nygma2004/RFID_Wiegand_MQTT/pcb/kit.jpg

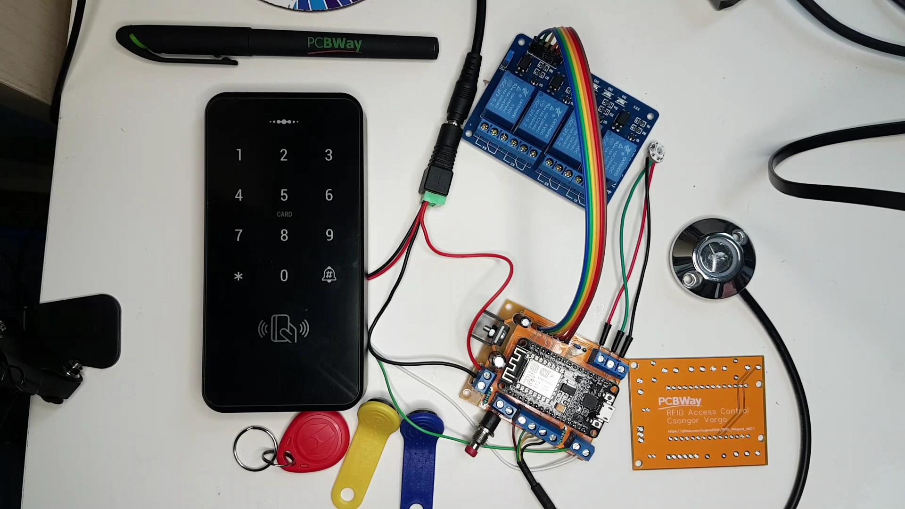
pcb/kit.jpg
