nygma2004/RFID_Wiegand_MQTT/pcb/Schematic_RFID_2021-03-26.pdf

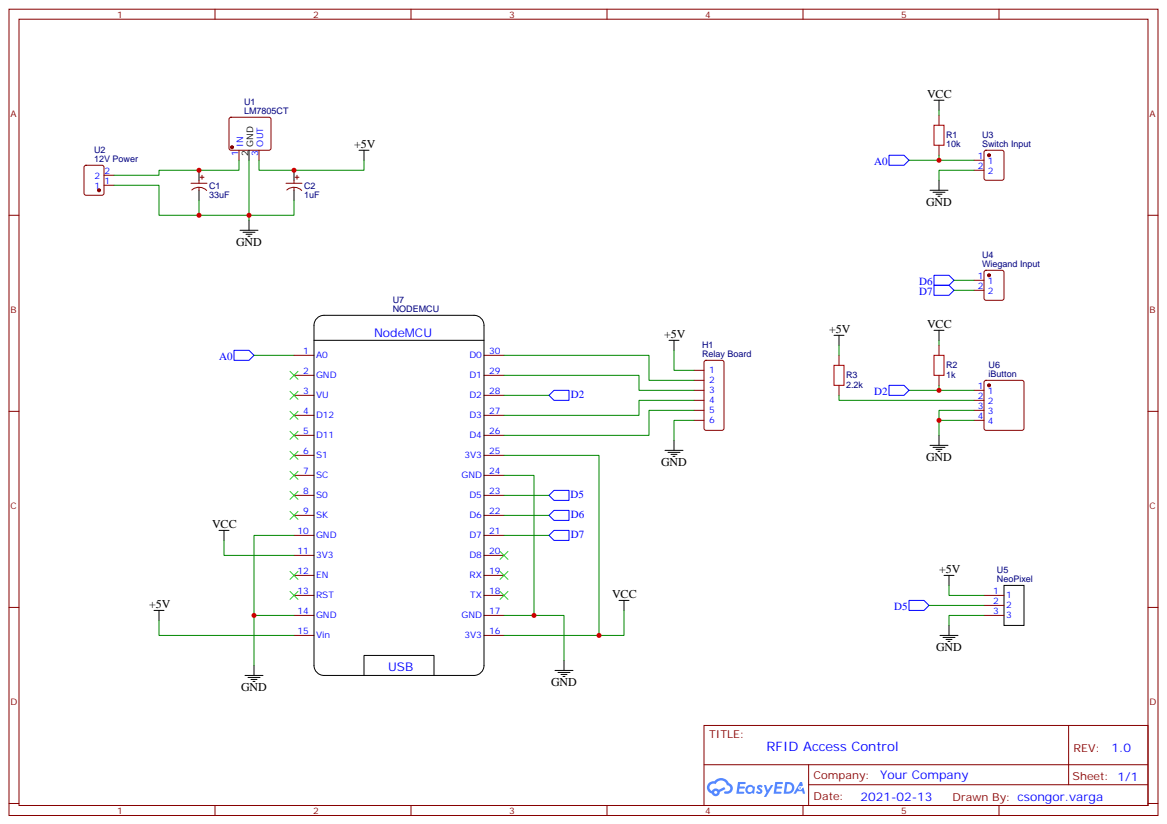
[picture p6: page 1]

Drawn By: csongor.varga
