nygma2004/RFID_Wiegand_MQTT/RFID_user_manual.pdf

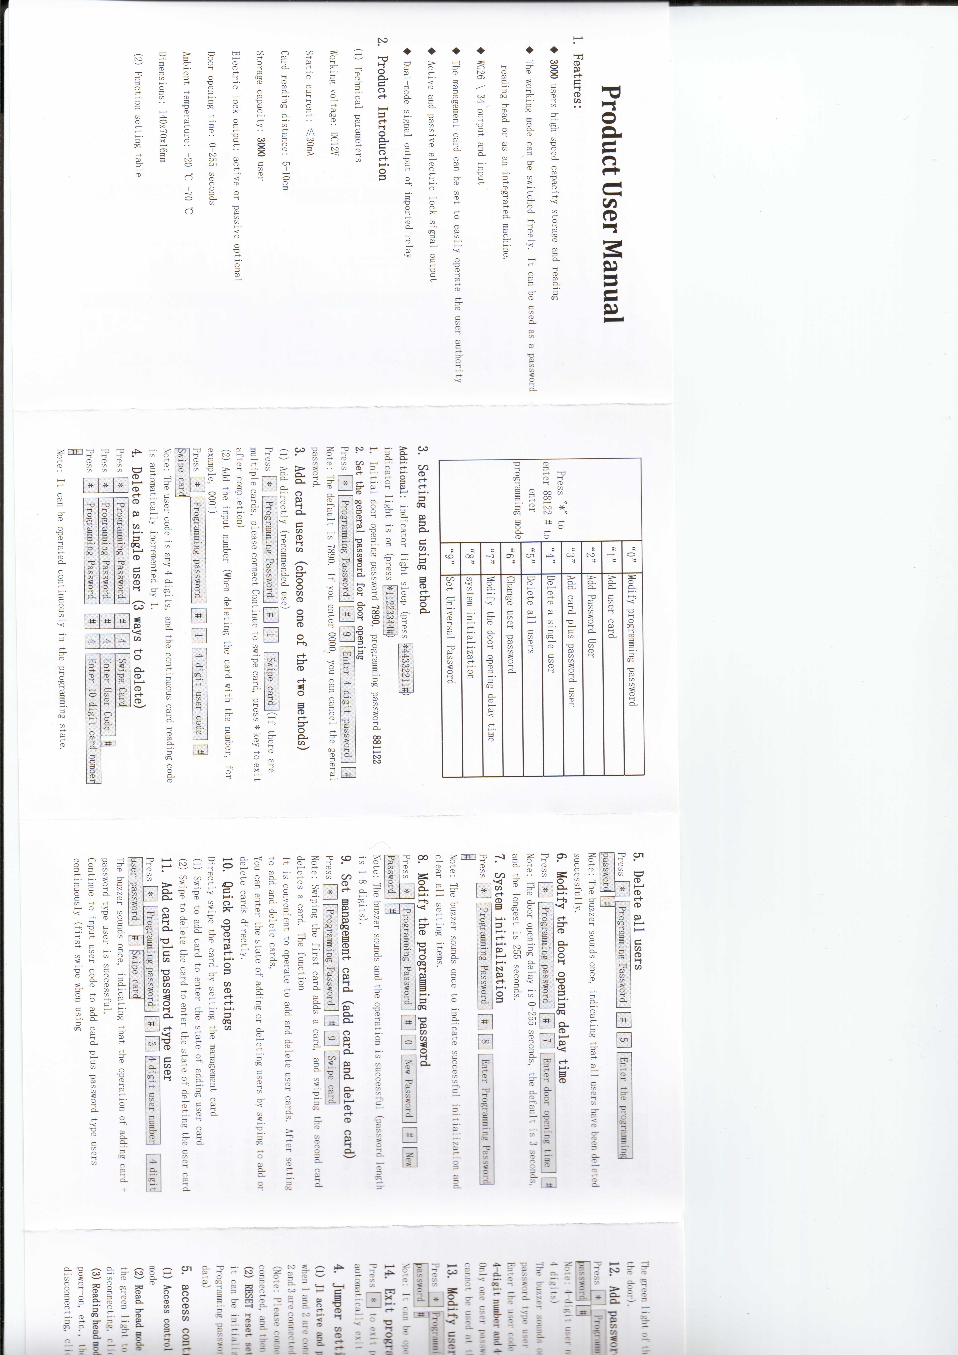
[picture p7: page 1]
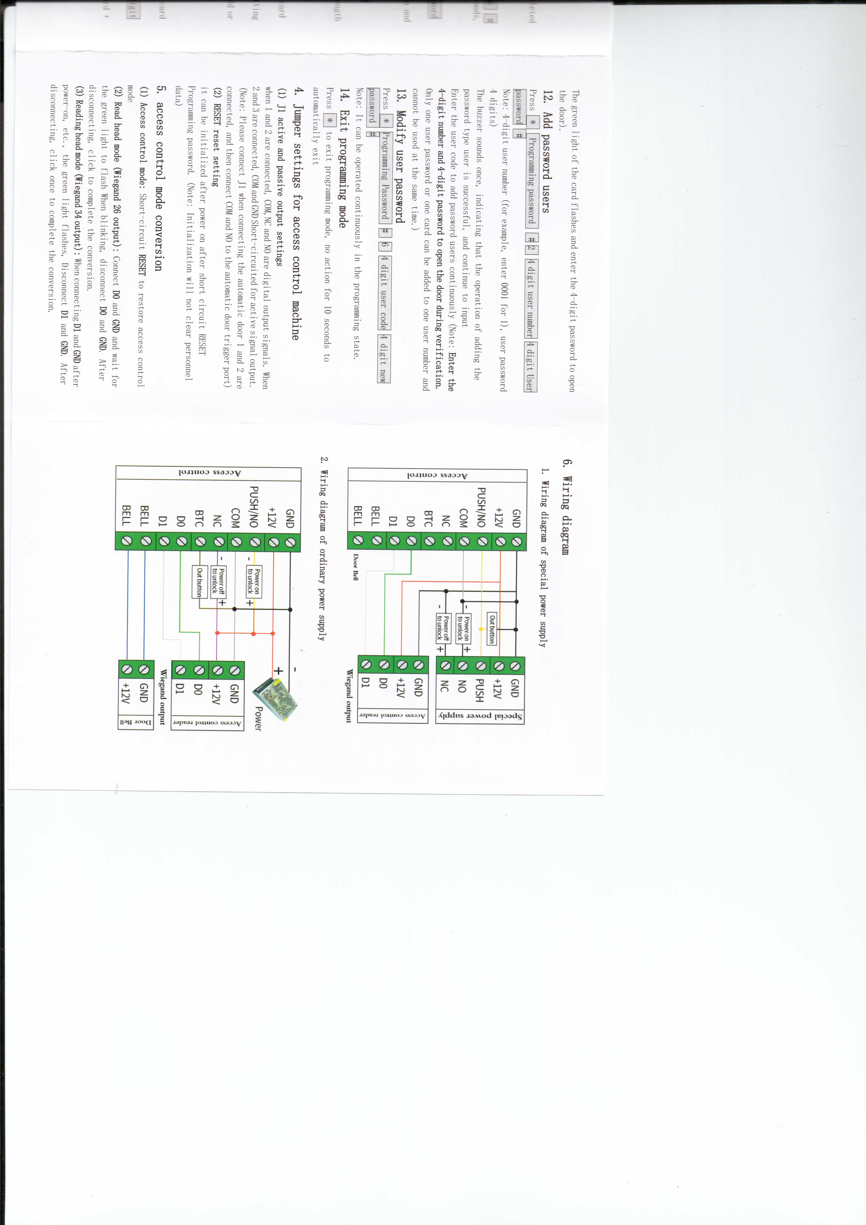
[picture p8: page 2]
