nygma2004/RFID_Wiegand_MQTT/(threads)

Thread 1 (2020-12-28):

Working as standalone reader?

thehijacker, 2020-12-28:
Hello,

Today I received the same reader as you have. Trying to connect it to my ESP-RFID board just as Wiegand signal receiver. I never receive any card data. It also always beeps that card is not recognised. When I use programming mode to add card the card is accepted and I can hear the relay switching. But still I do not get anything from the Wiegand lines.

Can it work as standalone reader? So it only scans the card, sends its data and do nothing else? I wish for ESP-RFID board to make proper buzzing sound if card is valid and not that RFID reader checks its database or fire the relay.

Have you figured this out when you first tested it?

Thank you for the tips.

Best regards,
Andrej

nygma2004, 2020-12-28:
I am away from home now, but if you open up the paper manual you have received for the device, there is section 5 in the end of the documentation how to set the device to Wiegang 16 reader module. I think you need to short D1 or D0 to the ground and connect to power. After that disconnect the device wire it to the ESP and it should work.

thehijacker, 2020-12-28:
Manual is a bit confusing.

D0 to GND for Wiegand 26 and D1 to GND for Wiegand 34. That is clear.

When I power on when D0 or D1 and to GND, green light indeed flashes and stops after few seconds. So I guess it is configured. But then in manual says "click to complete conversion". Not sure what that click is. If I power off and on it is still working the same. Using "internal" database and not sending anything to D0 and D1.

Do you perhaps remember how to store this setting?

Thank you!

thehijacker, 2020-12-28:
Figured it out. Need to disconnect D0 from GND when it starts blinking. Now reading works.

Did you perhaps looked at other things we can do with it? Like control buzzer and LED, control relay inside, use bell output, etc?

nygma2004, 2020-12-28:
I am not sure, it is not mentioned anywhere. But I ask the seller and will let you know what the response is.

thehijacker, 2020-12-29:
Thank you. Let me know if you get answer from him.

Best regards.

thehijacker, 2021-02-17:
Got reply from seller myself. Does not support beep or LED control over data lines.

We can close this :).

Closed 2021-02-17.

Thread 3 (2021-01-22):

Help with wiring the LED strip

thehijacker, 2021-01-22:
Hello,

Another question if I may.

Got the WS2812B LED strip. Bought 1 meter to wrap nicely around the RFID reader. Wondering how to connect this to Wemos D1 Mini.

It has 5 pins on each side. Three are joined together with special connected at end and two are separated.

https://imgaz1.staticbg.com/thumb/large/oaupload/banggood/images/DB/80/f6041a6e-f52a-485a-b8c2-73abf63ba60d.jpg.webp

https://www.banggood.com/1M-3M-5M-Built-in-IC-WS2812B-5050-RGB-LED-Strip-Light-Waterproof-Individually-Addressable-Programmable-Lamp-DC5V-p-1741353.html

You says to connect 5V + GND and DataIn. Those are three pins but I have five, on each side :).

So which one to use and must I use them on both side?

Thank you and best regards,
Andrej

nygma2004, 2021-01-22:
I believe in these strips the two white and two red cables are duplicates.
So white is GND, red is 5V and green is Data In which goes to the ESP Pin. And check the label on the strip which side is the Data In as it matters.
These are individually addressable LEDs and I am only addressing the first LED. So even you got an entire strip, only the first LED will work.
But you can fix it, first of all in `globals.h` there is this line:
`#define NUM_LEDS 1`
Change this to how many LEDs you have on the strip.
And you also have this function:

```
void SetLEDColor(String color) {

  if (color=="black") {
    leds[0] = CRGB::Black;
  }
  if (color=="yellow") {
    leds[0] = CRGB::Yellow;
  }
  if (color=="red") {
    leds[0] = CRGB::Red;
  }
  if (color=="green") {
    leds[0] = CRGB::Green;
  }
  if (color=="blue") {
    leds[0] = CRGB::Blue;
  }
  FastLED.show();
}
```

Here instead of led[0]... you need as many lines as many LED you have. If it is 10 you can just copy and paste the lines and use led[0]... led[1]... led[2]....
Or if more, build a for loop
```
for (int i=0; i<NUM_LEDS; i++) {
  led[i] = CRGB::<and the color>
}
```
And of course do this for each section.

thehijacker, 2021-01-22:
Thank you for great tips. One more question. Do you power the strip with Wemos or individual 5V power supply? I have separate 5V DC power supply planned and I can use it to power the strip. Only data in wire would go to Wemos then.

You think this would work?

thehijacker, 2021-01-22:
Tried it both. GND + 5V to separate 5V DC power supply and DataIn PIN only to D5 on Wemos. No LED gets lit.

Tried to connect GND + 5V to Wemos and DataIn pin to D5. Still the same. No LED gets lit.

I kept it for a while doing other things and when I looked at the strip single green LED was lit. No idea how.

Did you perhaps have simillar issues?

nygma2004, 2021-01-23:
I am not sure. If you are using a separate power supply, GND of the ESP and the power supply needs to be connected otherwise it will not work. But otherwise it should be working. I am not sure why you have issues.
I Googled it again and there are plenty of examples where the strip is connected directly on the ESP pin, on other there is a 470ohm resistor in series. Maybe on my neopixel board there is a built in resistor.

thehijacker, 2021-02-17:
LED strip was now working. I got refund. Bought one from another seller. That one works fine. Separate power supply, shared ground with Wemos and Data In to GPIO14 (D5) on Wemos. Full control.

Thank you.

Closed 2021-02-17.

Thread 4 (2021-03-31):

Typo in wiring chart?

byrnes-patrick, 2021-03-31:
Hi,

For the iButton it looks like it should be red to D2, green to vcc. I was able to see the trace on the pcb photo.

Thank you for posting this project, I love playing with it!

nygma2004, 2021-04-29:
Oh yes, that is correct. red is the data pin and it goes to D2. Green goes to Vcc via a resistor not blow the LED.

Thanks for thins, sorry it took much time.

Closed 2021-04-29.

Thread 5 (2021-04-28):

Pin create

bladedavid1, 2021-04-28:
Hi,

pls, can you edit node red flow, where can be create/edit PIN code for user?

nygma2004, 2021-04-29:
Well, you either add the codes manually in the inject node, or you can:
1. Enter the code on the keypad which will be logged as an Unknown Code
2. Select the user or even you want to assign it to.
3. Click on the Add Last Key button and that code will be assigned to the user

Thread 6 (2021-08-02):

All Pin Codes return an 'Unknown ID'

tapd, 2021-08-02:
Hi Csongor,

Firstly thank you for your time & effort on this project, it is saving me some time in doing the same thing. I have finally gotten around to test this out after watching your video months ago and I've encountered an issue with the pin codes. No matter which of the codes in the sample user list I enter at the keypad returns 'Unknown ID'. I changed the incoming code to a string in case that was the issue with no luck. Have you encountered this and could you please give me an indication of where the issue may lie.

Thank you.

tapd, 2021-08-03:
I think I've worked it out. I'm using a Rosslare keypad in Wiegand 26bit mode and the payload.type is "rfid" even though I'm keying in a pin. So I'm feeding the input through a change node to adjust it. The keyed pin also comes though as a number which I change to a string so that the function node will accept it.

nygma2004, 2021-08-04:
Sorry, bit lazy in the holiday season. Great that you managed to figure this out. And I am happy to see that it works with other Wiegand readers as well.

Closed 2022-03-27.

Thread 7 (2022-03-26):

RFID reader not outputting wiegand code?

RobbeM1991, 2022-03-26:
Hi, I bought the exact same Wiegand reader as yours.
But it's not outputting anything on the D0 and D1 lines (don't have a scope to measure though).

**Did you have to configure anything on the reader?**

Chapter 5 says something about:
1) Access control mode
2) Read head mode (Wiegand 26 output)
3) Reading head mode (Wiegand 34 output)
But the translation is not really clear and I'm not sure if I need it.
Especially the the reset function is not clear so I'm hesitating to try something...

Thanks!

thehijacker, 2022-03-26:
Chrck here.

https://github.com/nygma2004/RFID_Wiegand_MQTT/issues/1

RobbeM1991, 2022-03-26:
> Check here.
>
> #1

I've done exactly that. Connect D0 to GND, restart, disconnect when green light is flashing.
Then it is just blinking red...
But it's not recognizing any tags/codes in the web interface (add new user)?

So I'm not sure if I'm doing anything wrong...

When I enter the default password 7890, it gets detected as a new user though...

RobbeM1991, 2022-03-26:
It seems that I need to add a user first (on the RFID reader), and then it get's recognised when I enter the code.
But no matter which user ID + code i program, it always gets recognised as UID 15 in ESP-RFID...

I wanted the device to just send any code I enter or tag I scan and assign it to a User in ESP-RFID. Is that possible?

Closed 2022-03-26.

Thread 8 (2022-09-21):

Red LED constantly blinking in Wiegand mode

sglvladi, 2022-09-21:
Hi @nygma2004,

Thanks for the hard work and helpful guide.

I have bought myself the same reader from Amazon (see [here](https://www.amazon.co.uk/gp/product/B08YJGWNCB)), and I am able to read pin codes and card successfully.

My only issue is that, when in Wiegand mode, the red LED on my reader keeps flashing constantly, which I find a bit annoying. Having checked your Youtube videos, your device doesn't seem to be doing that, and instead the red led stays constantly on.

Any chance you have any clue about how to disable the blinking? I have posted a question to the seller on Amazon, but thought I'd also reach out here in case they never reply.

Thanks much in advance!

nygma2004, 2022-09-21:
I don't know why it is happening, but I noticed the same. I am using the same reader in Wiegand mode in a different setup (not with my ESP reader). And it works in that setup, but the red LED also blinks there constantly. The reader still works but I am not sure why it is different in these cases.
The Aliexpress seller was a lot more responsive, maybe you can try contacting them there.

sglvladi, 2022-09-30:
Thanks @nygma2004. It's good to know that I'm not alone at least.

Just a note for anyone reading this in the future, the module that has the flashing LED is a 125KHz module. I later bought a 13.56Mhz module and this one has the LED steady on.

Closed 2022-09-30.

Thread 10 (2022-12-06):

Fast Led warning. What version of Fast Led U are using

yogesh102011, 2022-12-06:
In file included from C:\Users\91887\Downloads\RFID_Wiegand_MQTT-main\RFID_Wiegand_MQTT-main\RFID_Wiegand_MQTT\RFID_Wiegand_MQTT.ino:36:
C:\Users\91887\Documents\Arduino\libraries\FastLED/FastLED.h:14:21: note: '#pragma message: FastLED version 3.003.000'
   14 | #    pragma message "FastLED version 3.003.000"
      |                     ^~~~~~~~~~~~~~~~~~~~~~~~~~~
In file included from C:\Users\91887\Documents\Arduino\libraries\FastLED/FastLED.h:65,
                 from C:\Users\91887\Downloads\RFID_Wiegand_MQTT-main\RFID_Wiegand_MQTT-main\RFID_Wiegand_MQTT\RFID_Wiegand_MQTT.ino:36:
C:\Users\91887\Documents\Arduino\libraries\FastLED/fastspi.h:130:23: note: '#pragma message: No hardware SPI pins defined.  All SPI access will default to bitbanged output'
  130 | #      pragma message "No hardware SPI pins defined.  All SPI access will default to bitbanged output"
      |                       ^~~~~~~~~~~~~~~~~~~~~~~~~~~~~~~~~~~~~~~~~~~~~~~~~~~~~~~~~~~~~~~~~~~~~~~~~~~~~~~~
Executable segment sizes:
ICACHE : 32768           - flash instruction cache
IROM   : 294388          - code in flash         (default or ICACHE_FLASH_ATTR)
IRAM   : 28369   / 32768 - code in IRAM          (IRAM_ATTR, ISRs...)
DATA   : 1632  )         - initialized variables (global, static) in RAM/HEAP
RODATA : 1904  ) / 81920 - constants             (global, static) in RAM/HEAP
BSS    : 26840 )         - zeroed variables      (global, static) in RAM/HEAP
Sketch uses 326293 bytes (31%) of program storage space. Maximum is 1044464 bytes.
Global variables use 30376 bytes (37%) of dynamic memory, leaving 51544 bytes for local variables. Maximum is 81920 bytes.

nygma2004, 2022-12-06:
It looks like I am using 3.3.3. I have not updated my libraries for a while.
