nygma2004/RFID_Wiegand_MQTT/(commit log)

2021-02-13 New functionality
    Adding code for ibutton onewire sensor (scanning ibuttons)
    Using the A0 analogue input as a digital input (get the state of the gate, garage door)
    4 output for relays: garage / gate door opener, etc.
2021-03-26 Adding more features
    ibutton + relay outputs + input
